planmarks/KUTSU-Pollution-Detector/KUTSU 1.0/Case/V1-Slim/V1-2/Kutsu-Case-Slim.png

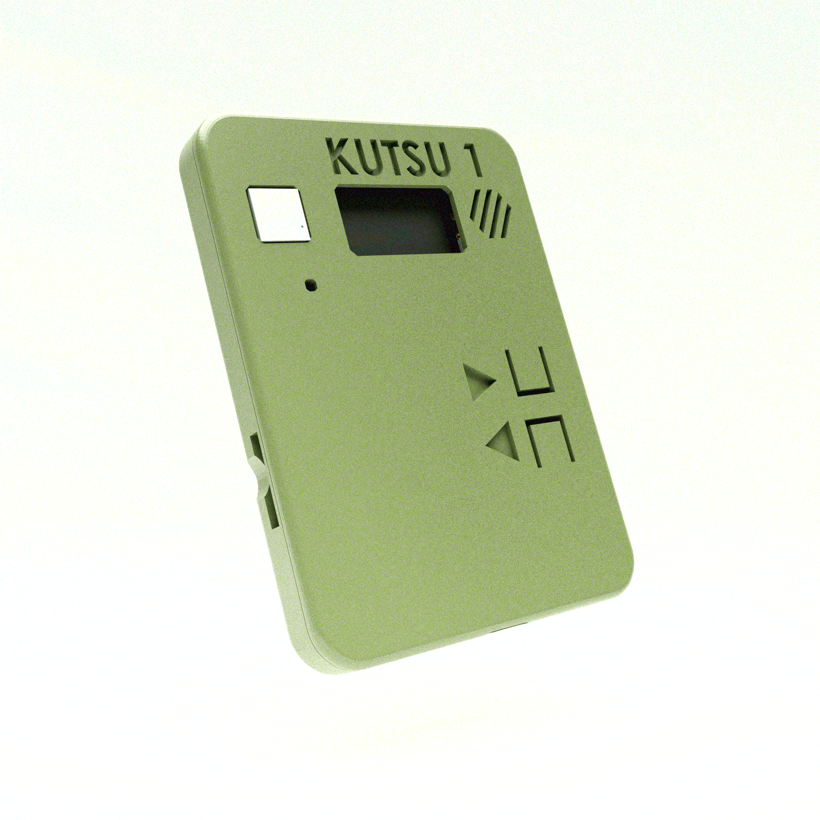
KUTSU 1.0/Case/V1-Slim/V1-2/Kutsu-Case-Slim.png
