planmarks/KUTSU-Pollution-Detector/KUTSU DIY/KUTSU Stationary/Firmware/KutsuSense/BOM.txt

Model	Use	Qty	Buy Link	Datasheet
ESP32-C5-DevKitC-1	MC	1		https://docs.espressif.com/projects/esp-dev-kits/en/latest/esp32c5/esp32-c5-devkitc-1/user_guide_v1.1.html
0.96" I2C OLED Display	Display	1	https://www.mouser.ee/ProductDetail/392-CSANAVIDISPLAY1	https://controllerstech.com/arduino-ssd1306-oled-display-tutorial/
HTU21D-F Temp & Humidity Sensor B/O	Term & Hum	1	https://www.mouser.ee/ProductDetail/485-1899	https://learn.adafruit.com/adafruit-htu21d-f-temperature-humidity-sensor/pinouts
CCS811 Carbon Dioxide Gas Sensor	CO2	1		
MQ-2 Gas and Smoke Sensor Module	Gasses	1		
"Adafruit Micro SD SPI or SDIO Card Breakout Board - 3V - 
4682 "	Memory	1	https://www.mouser.ee/ProductDetail/485-4682	https://learn.adafruit.com/adafruit-microsd-spi-sdio/pinouts
Buzzer 12 mm x 6.8 mm deep, P, 3 V, 78 dB, Through Hole, Audio Transducer -	Buzzer	1	https://www.mouser.ee/ProductDetail/179-CPT-1206-3TH-T	https://www.mouser.ee/datasheet/3/6118/1/cpt_1206_3th_t.pdf
LED Diode	Indicator	3
