planmarks/KUTSU-Pollution-Detector/KUTSU 1.0/BOM/Muru Product Compliance - Kutsu.csv

Reference | Qty | Part nr. / Value | MPN | Footprint | Buy Link 1 | Buy Link 2 | Datasheet | RoHS Comp | RoHS Docs | EMC Test link | CPU | Cost
XIAO | 1 | XIAO ESP32-C5 | 100010048 |  | https://www.digikey.ee/en/products/detail/seeed-technology-co-ltd/100010048/28959910 |  | https://files.seeedstudio.com/Bazaar/product_pdf/100010048.pdf | ROHS3 Compliant | https://files.seeedstudio.com/Seeed_Certificate/documents_certificate/100010048-ROHS.pdf |  | $6.90 | $6.90
XIAO | 1 | XIAO ESP32-C3 | 113991054 |  | https://www.digikey.ee/en/products/detail/seeed-technology-co-ltd/113991054/16652880 |  | https://mm.digikey.com/Volume0/opasdata/d220001/medias/docus/6209/Seeed%20113991054.pdf | ROHS3 Compliant | https://files.seeedstudio.com/Seeed_Certificate/documents_certificate/113991054-ROHS.pdf |  | $5.25 | $5.25
DS1 (DIY) | 1 | 0.96" I2C OLED Display | DLC0096DNOG-W-10 |  | https://www.digikey.ee/en/products/detail/dlc-display-co-ltd/DLC0096DNOG-W-10/24764440 |  | https://www.dlcdisplay.com/viewfilebizce/1793559811954421760/DLC0096DNOG-W-10.pdf | ROHS3 Compliant | No public RoHS doc found - request from DLC Display |  | $3.30 | $3.30
DS1 | 1 | OLED-128O064D 128×64 | DLC0096DNOG-W-5 |  | https://www.digikey.ee/en/products/detail/dlc-display-co-ltd/dlc0096dnog-w-5/13624832 |  | https://www.dlcdisplay.com/viewfilebizce/1760131013944299520/DLC0096DNOG-W-5.pdf | RoHS Compliant |  |  | €18.48 | €18.48
U3 | 1 | SCD41-D-R2 | SCD41-D-R2 |  | https://www.digikey.ee/en/products/detail/sensirion-ag/scd41-d-r2/13684005 |  | https://sensirion.com/media/documents/48C4B7FB/67FE0194/CD_DS_SCD4x_Datasheet_D1.pdf | ROHS3 Compliant | https://sensirion.com/media/documents/54BDF766/69E07F5E/Sensirion_REACH-RoHS-HalFree_CO2-Sensors.pdf |  | $21.77 | $21.77
U1 | 1 | SGP41-D-R4 | SGP41-D-R4 |  | https://www.digikey.ee/en/products/detail/sensirion-ag/sgp41-d-r4/15652788 |  | https://sensirion.com/media/documents/5FE8673C/61E96F50/Sensirion_Gas_Sensors_Datasheet_SGP41.pdf | ROHS3 Compliant | https://sensirion.com/media/documents/9152E5A6/69E080A2/Sensirion_REACH-RoHS-HalFree_Humidity-Temperature.pdf |  | $9.01 | $9.01
U2 | 1 | SHT40-AD1B-R3 | SHT40-AD1B-R3 |  | https://www.digikey.ee/en/products/detail/sensirion-ag/sht40-ad1b-r3/14322709 |  | https://sensirion.com/media/documents/33FD6951/6A7C10A0/HT_DS_Datasheet_SHT4x_V7.3.pdf | ROHS3 Compliant | https://sensirion.com/media/documents/9152E5A6/69E080A2/Sensirion_REACH-RoHS-HalFree_Humidity-Temperature.pdf |  | $1.88 | $1.88
D2 | 1 | Red LED Diode | LTST-C190KRKT | 603 | https://www.digikey.ee/en/products/detail/liteon/LTST-C190KRKT/386817 |  | https://optoelectronics.liteon.com/upload/download/DS-22-99-0151/LTST-C190KRKT.pdf | ROHS3 Compliant | https://optoelectronics.liteon.com/en-global/Page/RoHS |  | $0.14 | $0.14
SW1-SW3 | 3 | Push button | PTS526SK15SMTR2 LFS |  | https://www.digikey.ee/en/products/detail/c-k/PTS526SK15SMTR2-LFS/10056626 |  | https://www.littelfuse.com/assetdocs/littelfuse-c-k-tactile-pts526-series-datasheet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 | ROHS3 Compliant | https://www.littelfuse.com/assetdocs/coc-rohs10-08-18-2022?assetguid=6d7cc3c6-97e3-4940-98fc-322868282297 |  | $0.16 | $0.64
SW4 | 1 | On-Off Switch | OS102011MA1QN1 |  | https://www.digikey.ee/en/products/detail/c-k/OS102011MA1QN1/1981430 |  | https://www.littelfuse.com/assetdocs/littelfuse-c-k-slide-os-series-datasheet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 | ROHS3 Compliant | https://www.littelfuse.com/assetdocs/coc-rohs10-08-18-2022?assetguid=6d7cc3c6-97e3-4940-98fc-322868282297 |  | $0.71 | $0.71
MicroSD Connector | 1 | MSD-11-A | CONN MICROSD CARD R/A SMD |  | https://www.digikey.ee/en/products/detail/same-sky-formerly-cui-devices/msd-11-a/21798680 |  | https://www.cuidevices.com/product/resource/digikeypdf/msd-11-a.pdf | RoHS Compliant | https://www.sameskydevices.com/product/resource/material-compliance/msd-11-a |  | $0.42 | $0.42
C1 | 1 | 10uF | C0805C106K8PACTU | 805 | https://www.digikey.ee/en/products/detail/kemet/C0805C106K8PACTU/1090830 |  | https://yageogroup.com/content/datasheet/asset/file/KEM_C1006_X5R_SMD | ROHS3 Compliant | https://yageogroup.com/component-documentation/download/rohs/C0805C106K8PACTU.pdf |  | $0.17 | $0.17
C2, C3, C4, C5, C6, C7 | 6 | 0.1uF | C0805C104K5RACTU | 805 | https://www.digikey.ee/en/products/detail/kemet/C0805C104K5RACTU/411169 |  | https://yageogroup.com/content/datasheet/asset/file/KEM_C1002_X7R_SMD | ROHS3 Compliant | https://yageogroup.com/component-documentation/download/rohs/C0805C104K5RACTU.pdf |  | $0.16 | $0.96
R1, R2, R3, R4, R5, R6, R7, R10, R11 | 9 | 4.7K | RC0805FR-074K7L | 805 | https://www.digikey.ee/en/products/detail/yageo/RC0805FR-074K7L/727929 |  | https://yageogroup.com/content/datasheet/asset/file/PYU-RC_GROUP_51_ROHS_L | ROHS3 Compliant | https://yageogroup.com/content/Resource%20Library/Product%20Environmental%20Compliance/RoHS_Compliance_YAGEO.pdf |  | $0.10 | $0.90
R8 | 1 | 20K | RC0402FR-0720KL | 805 | https://www.digikey.ee/en/products/detail/yageo/RC0402FR-0720KL/726557 |  | https://yageogroup.com/content/datasheet/asset/file/PYU-RC_GROUP_51_ROHS_LL | ROHS3 Compliant | https://yageogroup.com/content/Resource%20Library/Product%20Environmental%20Compliance/RoHS_Compliance_YAGEO.pdf |  | $0.10 | $0.10
R9 | 1 | 10K | RMCF0805FT10K0 | 805 | https://www.digikey.ee/en/products/detail/stackpole-electronics-inc/RMCF0805FT10K0/1760676 |  | https://www.seielect.com/catalog/SEI-RMCF_RMCP.pdf | ROHS3 Compliant | https://www.seielect.com/catalog/SEI-RoHS_Compliance_Status.pdf |  | $0.10 | $0.10
MQ2 | 0-1 | MQ-2 Gas and Smoke Sensor Module |  |  |  | https://www.az-delivery.de/en/products/gas-sensor-modul |  | RoHS Compliant | https://cdn.shopify.com/s/files/1/1509/1638/files/AZ-scan20190814.pdf?104457 |  | €5.99 | €5.99
SD (DIY) | 0-1 | Adafruit Micro SD SPI |  |  |  | https://www.adafruit.com/product/4682 |  | ROHS3 Compliant | No public RoHS doc found - request from Adafruit (support@adafruit.com) |  | $3.50 | $3.50
D1 | 1 | Laser Diode | 1054 |  | https://www.digikey.ee/en/products/detail/adafruit-industries-llc/1054/5629439 |  | https://mm.digikey.com/Volume0/opasdata/d220001/medias/docus/1130/1054_Web.pdf | ROHS3 Compliant | No public RoHS doc found - request from Adafruit (support@adafruit.com) |  | $5.95 | $5.95
BZ 1 | 1 | Buzzer | SMT-1028-T-2-R |  | https://www.digikey.com.au/en/products/detail/pui-audio-inc/SMT-1028-T-2-R/6007733 |  | https://puiaudio.com/file/specs-SMT-1028-T-2-R.pdf | ROHS3 Compliant | https://puiaudio.com/rohs-reach-declaration/?pn=SMT-1028-T-2-R&print=pdf |  | $6.45 | $6.45
BZ 2 | 0-1 | Buzzer | SMT-1028-T-2-R |  | https://www.digikey.ee/en/products/detail/soberton-inc/WST-1203UX/1245301 |  | https://www.soberton.com/wp-content/uploads/2019/02/WST-1203UX.-17-Feb-2019-pdf.pdff | ROHS3 Compliant | https://www.soberton.com/wp-content/uploads/2019/10/RoHS-3.0-CoC-2019.pdf |  | $1.97 | $1.97
PCB | 1 | PCB |  |  |  |  |  | TBD - depends on PCB fab (specify lead-free HASL/ENIG) | TBD - request RoHS report from PCB fab |  | $5.00 | $0.50
 |  |  |  |  |  |  |  |  |  |  | Total Base | $14.84
 |  |  |  |  |  |  |  |  |  |  | Total DIY | $23.94
 |  |  |  |  |  |  |  |  |  |  | Total Base | $23.94
 |  |  |  |  |  |  |  |  |  |  | Total Pro | $70.71
