planmarks/KUTSU-Pollution-Detector/KUTSU 1.0/3D/kutsu-board-esp32c5-devkitc-test.stl

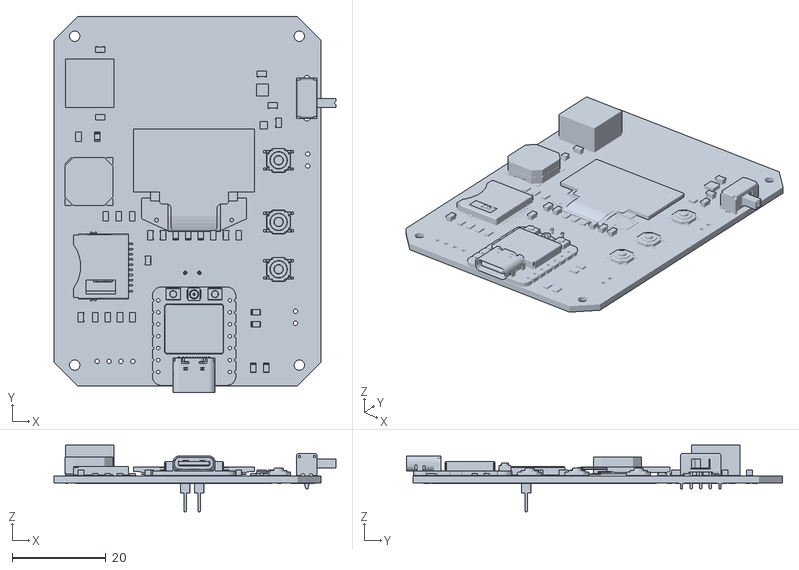
[picture p5: CAD file, 2026-10-02]
KUTSU 1.0/3D/kutsu-board-esp32c5-devkitc-test.stl
60.0 x 80.0 x 14.2
