planmarks/KUTSU-Pollution-Detector/KUTSU 1.0/Case/Kutsu 1 Case.3mf

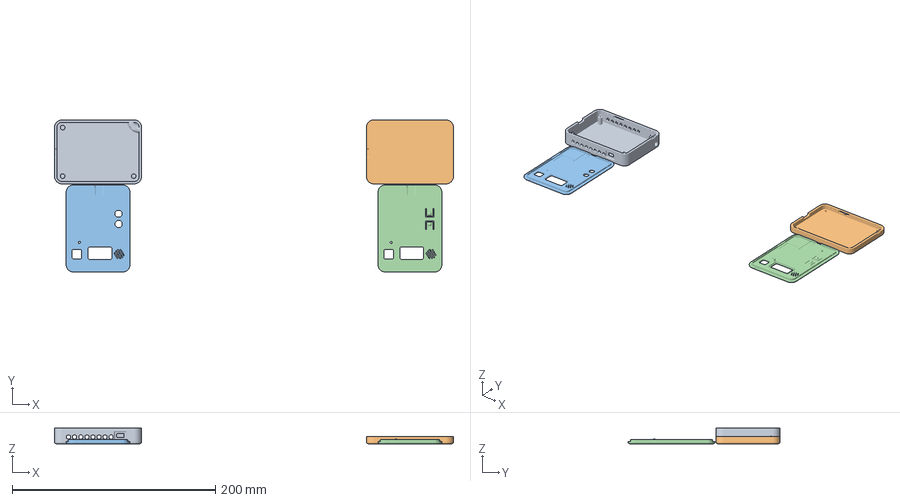
[picture p6: CAD file, 2026-10-26]
KUTSU 1.0/Case/Kutsu 1 Case.3mf
393.0 x 149.8 x 15.3 mm
Kutsu 1 CaseCaseBottom.stl
Kutsu 1 CaseCaseBottom.001.stl
Kutsu 1 CaseCsseTop.stl
Kutsu 1 CaseCsseTop.001.stl
