planmarks/KUTSU-Pollution-Detector/KUTSU 1.0/Case/V1-Slim/Kutsu 1 CaseCsseTop.001.stl

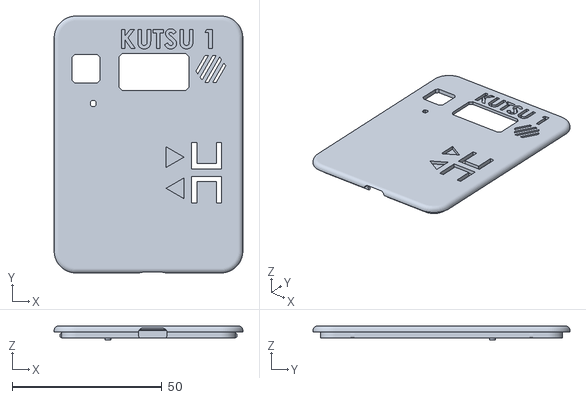
[picture p7: CAD file, 2026-10-26]
KUTSU 1.0/Case/V1-Slim/Kutsu 1 CaseCsseTop.001.stl
63.0 x 85.8 x 4.72
