planmarks/KUTSU-Pollution-Detector/KUTSU 1.0/Case/V1-Slim/V1-2/Kutsu 1 CaseCaseBottom.001.stl

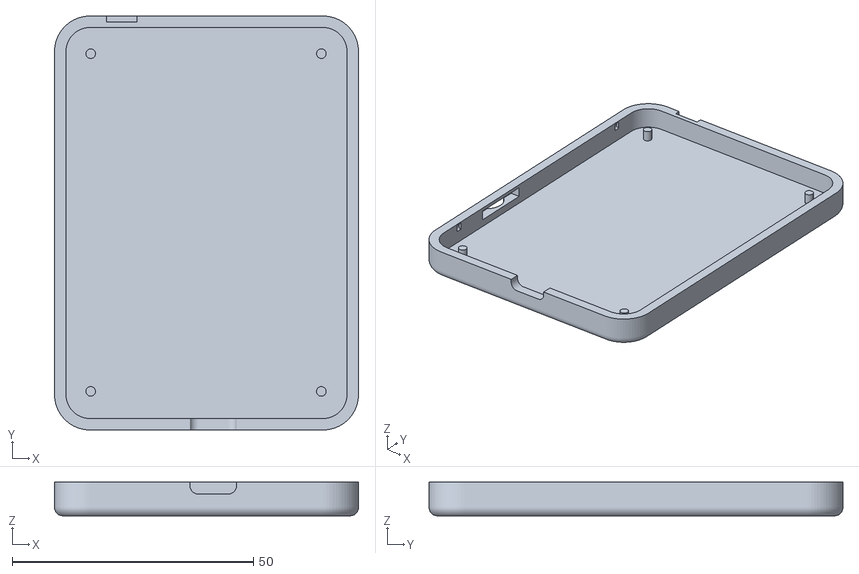
[picture p8: CAD file, 2026-10-26]
KUTSU 1.0/Case/V1-Slim/V1-2/Kutsu 1 CaseCaseBottom.001.stl
63.0 x 85.8 x 7.00
