planmarks/KUTSU-Pollution-Detector/KUTSU 1.0/Case/V1/Kutsu 1 CaseCube.002.stl

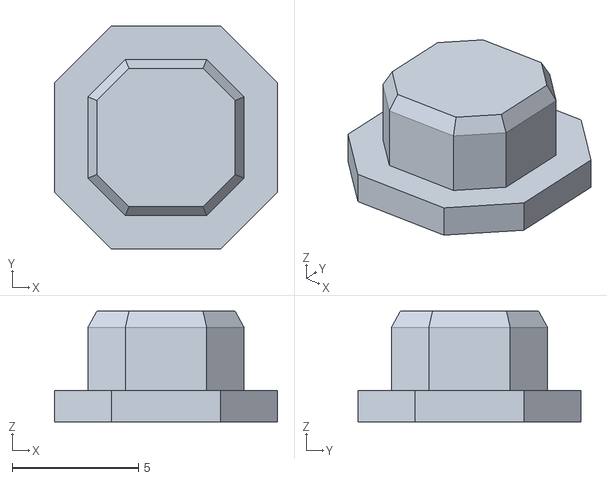
[picture p9: CAD file, 2026-10-26]
KUTSU 1.0/Case/V1/Kutsu 1 CaseCube.002.stl
8.84 x 8.84 x 4.39
