planmarks/KUTSU-Pollution-Detector/KUTSU 1.0/Case/V1/v1-1/Kutsu 1 CaseCaseBottom.stl

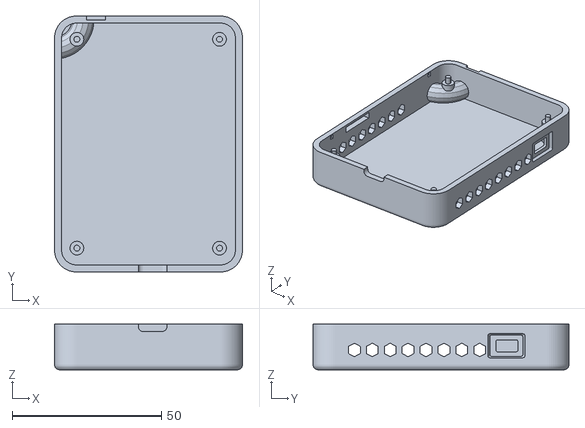
[picture p10: CAD file, 2026-10-26]
KUTSU 1.0/Case/V1/v1-1/Kutsu 1 CaseCaseBottom.stl
63.0 x 85.8 x 15.3
