planmarks/KUTSU-Pollution-Detector/KUTSU DIY/KUTSU Handheld/3D/kutsu-board-xiao-esp32c5c3.stl

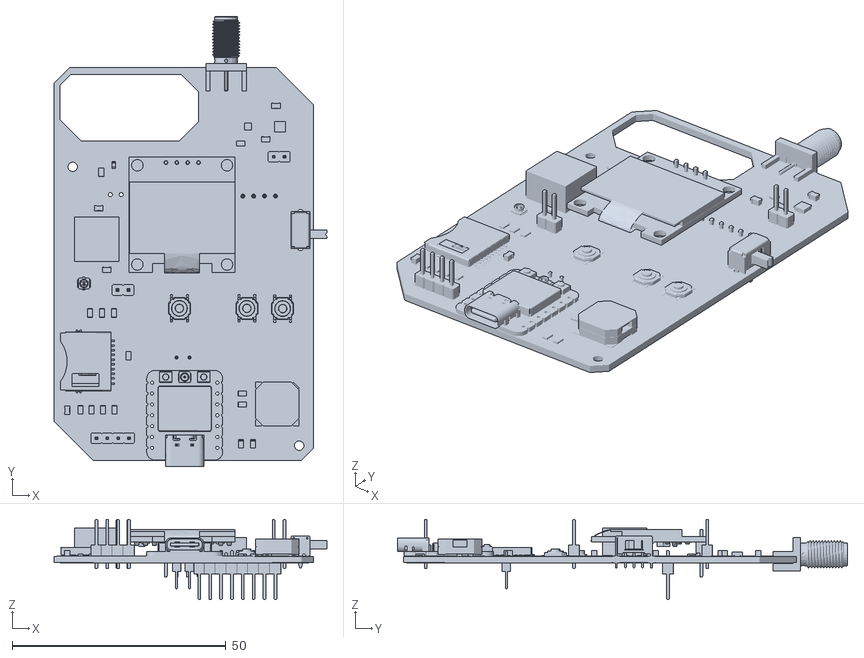
[picture p11: CAD file, 2026-10-02]
KUTSU DIY/KUTSU Handheld/3D/kutsu-board-xiao-esp32c5c3.stl
63.8 x 105.2 x 18.8
