planmarks/KUTSU-Pollution-Detector/KUTSU 1.0/Case/V1/Kutsu 1 CaseCaseBottom.001.stl

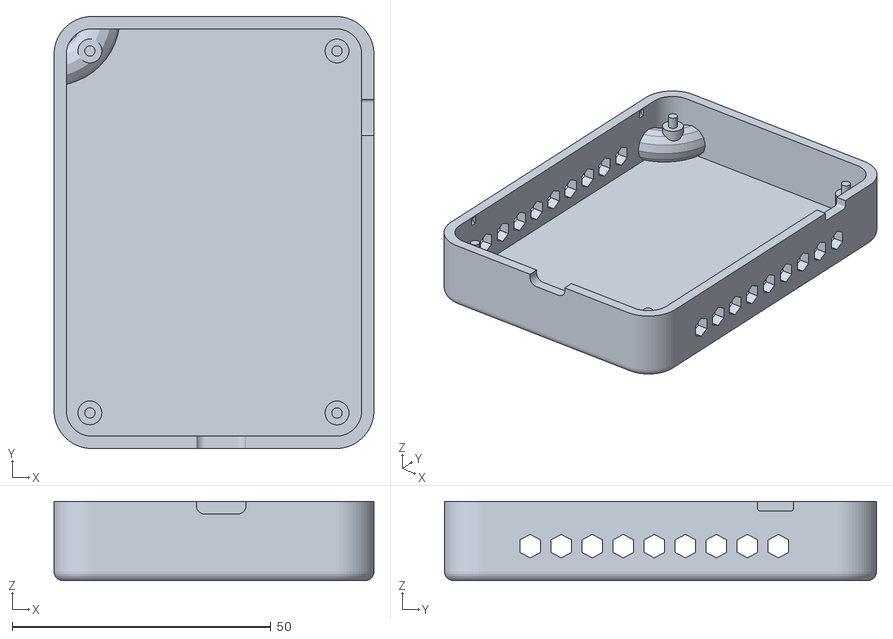
[picture p12: CAD file, 2026-10-26]
KUTSU 1.0/Case/V1/Kutsu 1 CaseCaseBottom.001.stl
61.9 x 83.6 x 15.3
