planmarks/KUTSU-Pollution-Detector/KUTSU 1.0/Case/V1/v1-1/Kutsu 1 CaseCsseTop.stl

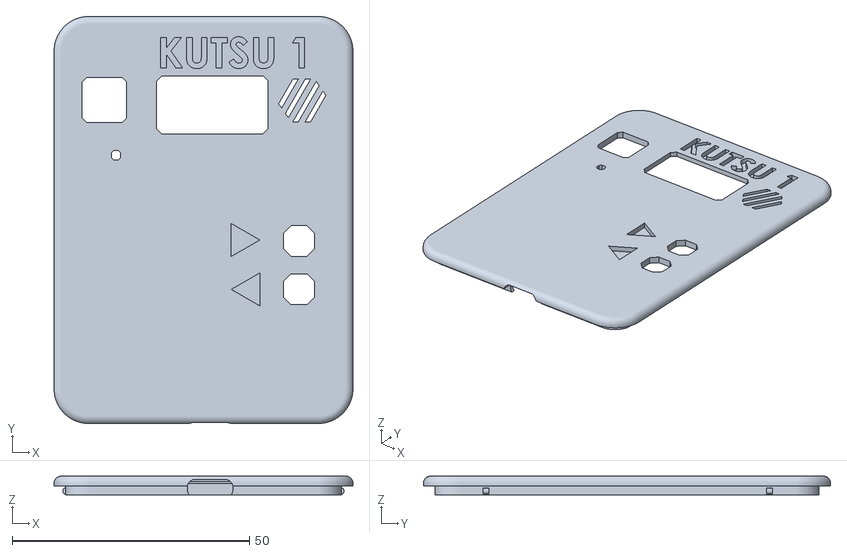
[picture p13: CAD file, 2026-10-26]
KUTSU 1.0/Case/V1/v1-1/Kutsu 1 CaseCsseTop.stl
63.0 x 85.8 x 3.98
