planmarks/KUTSU-Pollution-Detector/KUTSU 1.0/Case/V1/Kutsu 1 CaseCube.016.stl

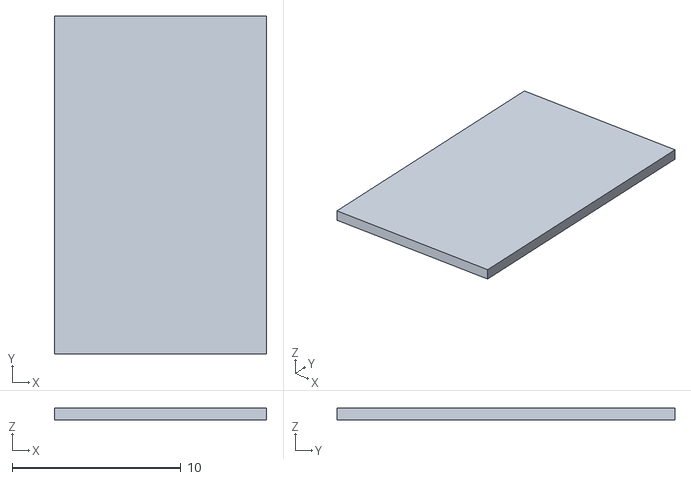
[picture p14: CAD file, 2026-10-26]
KUTSU 1.0/Case/V1/Kutsu 1 CaseCube.016.stl
12.6 x 20.0 x 0.711
