planmarks/KUTSU-Pollution-Detector/KUTSU 1.0/Case/V1/Kutsu 1 CaseCube.008.stl

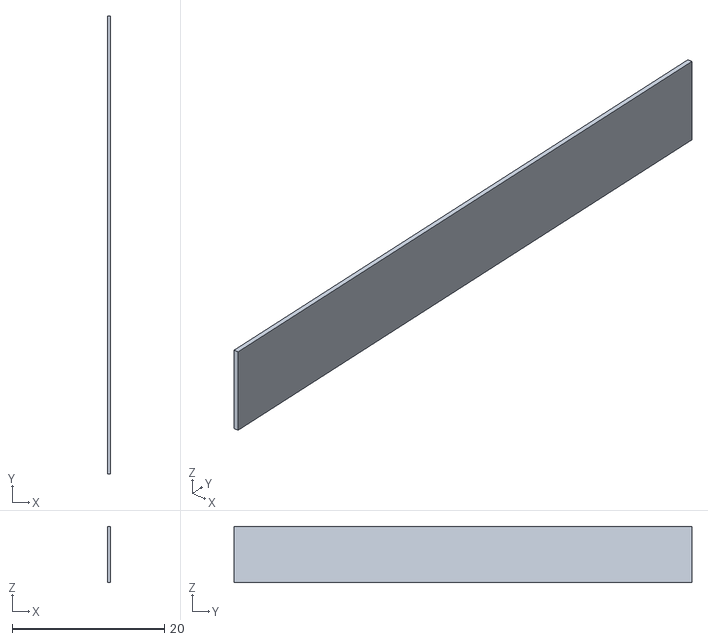
[picture p16: CAD file, 2026-10-26]
KUTSU 1.0/Case/V1/Kutsu 1 CaseCube.008.stl
0.429 x 60.2 x 7.39
