planmarks/KUTSU-Pollution-Detector/(list of files, cad)

Other CAD files:
KUTSU DIY/KUTSU Stationary/3D/kutsu-board-esp32c5-devkitc-test.stl
KUTSU 1.0/Case/V1-Slim/Kutsu 1 CaseCaseBottom.001.stl
KUTSU 1.0/Case/V1-Slim/V1-2/Kutsu 1 CaseCsseTop.001.stl
KUTSU 1.0/3D/Kutsu Handheld 3D Model.blend
KUTSU 1.0/Case/Kutsu 1 Case.blend
KUTSU 1.0/Case/Render.blend
KUTSU DIY/KUTSU Handheld/3D/Kutsu Handheld 3D Model.blend
KUTSU DIY/KUTSU Stationary/3D/Kutsu Stationary 3D Model.blend
