planmarks/KUTSU-Pollution-Detector/KUTSU 1.0/KutsuSetupApp/index.html

# Kutsu Setup

Connect a Kutsu Sense device and get it on your network.

This browser can’t talk to hardware. Open Kutsu Setup in desktop Google Chrome or Microsoft Edge (v89+). Web Bluetooth / Web Serial aren’t available in Firefox or Safari.

## Connect your device

Connect over Bluetooth Connect via USB

Power the device on and keep it nearby. Bluetooth is wireless; USB needs the cable (and works even before WiFi exists).

Need to flash or update firmware? Open Kutsu Flasher ↗ — installs the latest firmware over USB in your browser.

## Device

Connected Disconnect

## WiFi setup

Network name (SSID)

Password

Show

Room / location label (optional)

Save & connect Forget WiFi

2.4 GHz networks are the safe choice — every Kutsu module has 2.4 GHz; only the C5 also joins 5 GHz.

## Device settings

Device name

Save

A creature name is assigned at the factory. Clear the field and Save to restore it.

Mode

Stationary joins WiFi and feeds the KUTSU Hub; handheld stays off WiFi.

Handheld Stationary

Buzzer

Audible alarm on dangerous readings.

Warning LED

Lights on warning / alert.

Display

OLED screen (device keeps running when off).

WiFi & BLE scanning

Nearby networks/devices screens. Setup stays reachable either way.

Buzzer signal

Plays a preview on the device when changed.

LED — warning

How the LED behaves at warning level.

LED — alert

How the LED behaves at alert level.

Changes save to the device immediately.

## Warning thresholds

Restore defaults

Warn = the “!” level; Alert = full alarm. Blank fields are left unchanged.

## Live readings

–

CO₂ ppm

–

VOC idx

–

NOx idx

–

Temp °C

–

Hum %

Updates live while connected. Readings stream over Bluetooth, or from the device log over USB.

Activity log

Kutsu Setup · local provisioning · by Papathought · runs entirely on your computer
