planmarks/KUTSU-Pollution-Detector/KUTSU 1.0/kutsu-10-xiao-esp32c5c3.kicad_pcb

## KiCad design KUTSU 1.0/kutsu-10-xiao-esp32c5c3.kicad_pcb (2026-10-02)

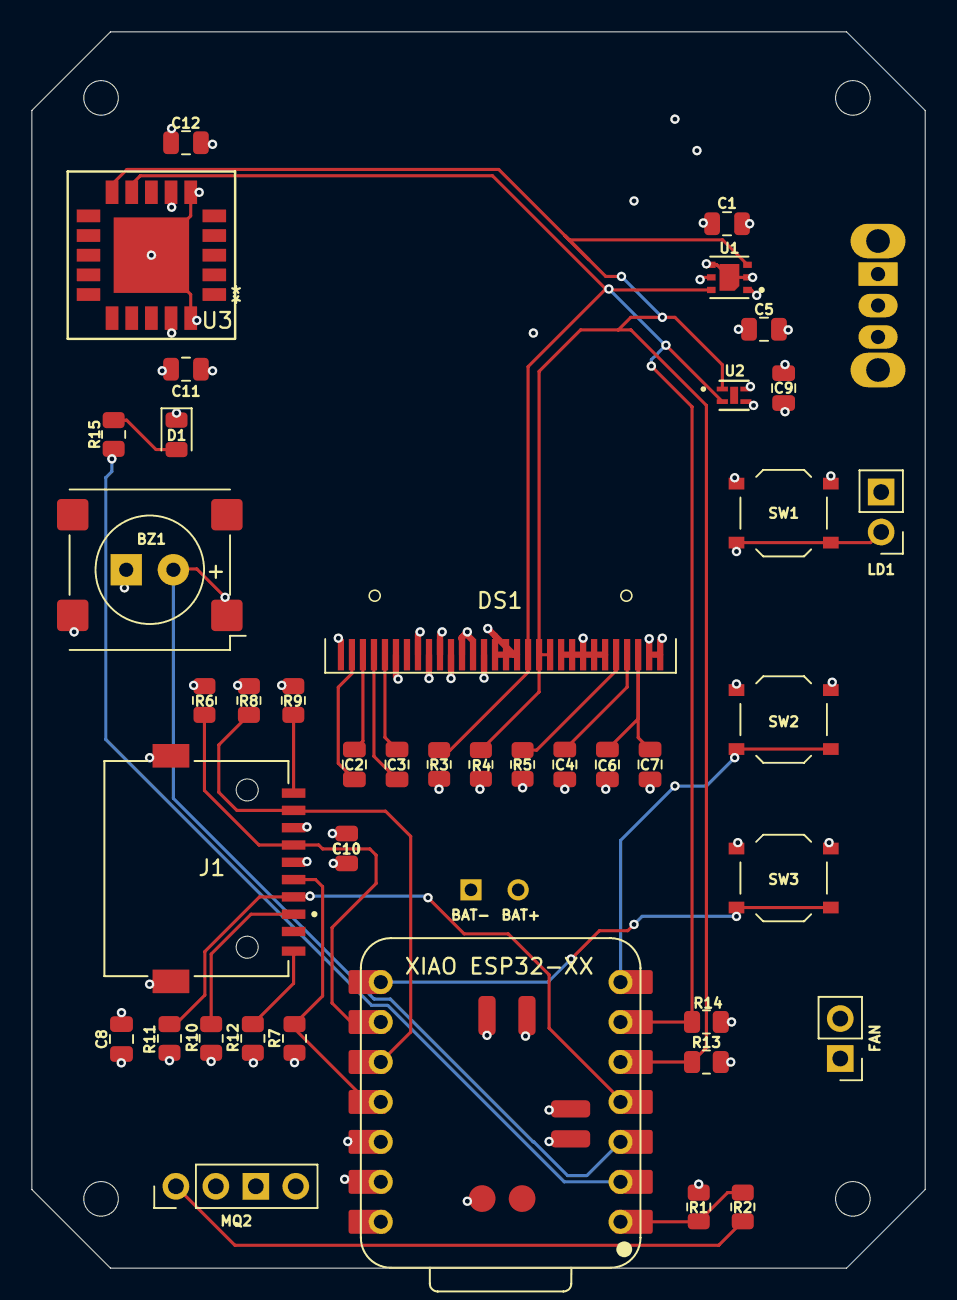
[picture p17: board kutsu-10-xiao-esp32c5c3.kicad_pcb from above]

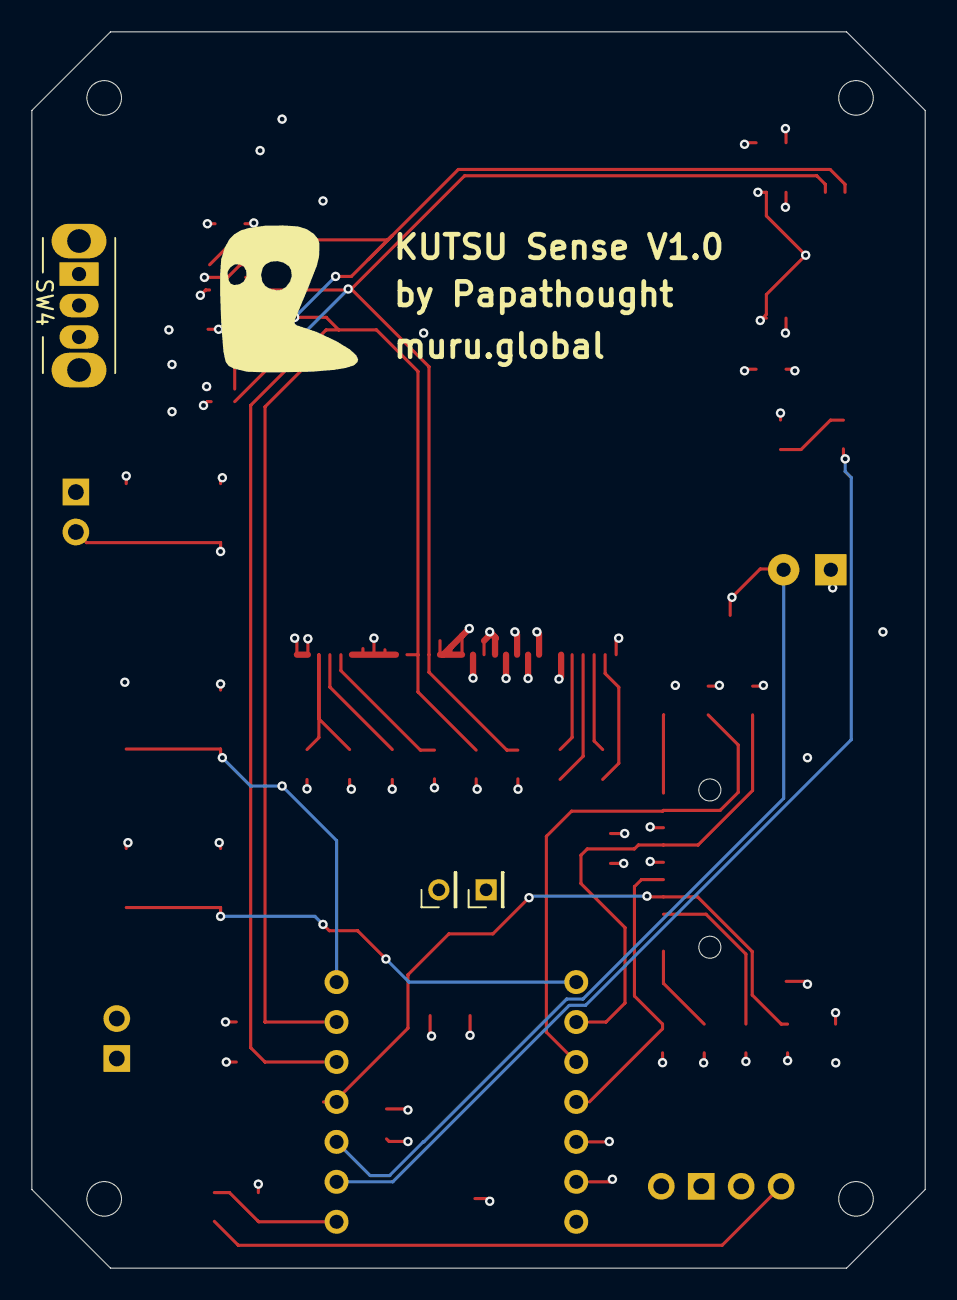
[picture p18: board kutsu-10-xiao-esp32c5c3.kicad_pcb from below]

Board: 4 copper layers, 56.8 x 78.6 mm, 45 parts (3 on the bottom side), 28 nets.

Parts:
BAT+: PinHeader_1x01_P2.00mm_Vertical
BAT-: PinHeader_1x01_P2.00mm_Vertical
BZ1: Buzzer; MagneticBuzzer_PUI_SMT-1028-T-2-R
BZ1#2: MagneticBuzzer_Kobitone_254-EMB73-RO
C1, C5, C6, C9, C10, C11, C12: 0.1uF; C_0805_2012Metric
C2, C3: 2.2 µF; C_0805_2012Metric
C4: 1uF; C_0805_2012Metric
C7: 2uF; C_0805_2012Metric
C8: 10uF; C_0805_2012Metric
D1: LED; LED_0805_2012Metric
DS1: OLED-128O064D
FAN: PinHeader_1x02_P2.54mm_Vertical
J1: MSD-11-A; CUI_MSD-11-A
LD1: D_Laser_1A3C; PinHeader_1x02_P2.54mm_Vertical
MQ2: PinHeader_1x04_P2.54mm_Vertical
R1: 20K; R_0805_2012Metric
R2: 10K; R_0805_2012Metric
R3, R4, R6, R7, R8, R9, R10, R11, R12, R13, R14, R15: 4.7K; R_0805_2012Metric
R5: 390K; R_0805_2012Metric
SW1, SW2, SW3: SW_Push; SW_Push_1P1T_XKB_TS-1187A
SW4: SW_SPDT; SW_Slide_SPDT_Angled_CK_OS102011MA1Q
U1: SGP41-D-R4; XDCR_SGP41-D-R4
U2: SHT40-AD1B-R3; DFN4_SHT4x_SEN
U3: SCD41-D-R2; QFN20_SCD41-D-R2_SEN
XIAO ESP32: XIAO-ESP32-C5-DIP

Connections:
5V: FAN.2, MQ2.4, XIAO ESP32.14
+3V3: C1.2, C5.1, C8.1, C9.1, C10.1, C11.1, C12.2, DS1.6 (VBAT), DS1.9 (VDD), DS1.11 (BS1), DS1.14 (~RES), J1.P4 (VDD), R3.1, R4.1, R6.2, R7.2, R8.2, R9.2, R10.2, R11.2, R12.2, R13.1, R14.1, SW1.2, U1.1 (VDD), U1.5 (VDDH), U2.3 (VDD), U3.7 (VDD), U3.19 (VDDH), XIAO ESP32.12
AO: MQ2.1, R2.2
BTN1: SW2.1, XIAO ESP32.7
BTN2: SW3.2, XIAO ESP32.8
BTSW1: BAT+.1, SW4.2 (B)
D1: R15.2, XIAO ESP32.2
GND: BZ1.2 (-), BZ1#2.2, C1.1, C4.2, C5.2, C6.2, C7.2, C8.2, C9.2, C10.2, C11.2, C12.1, D1.1 (K), DS1.1 (GND), DS1.8 (VSS), DS1.10 (BS0), DS1.12 (BS2), DS1.13 (~CS), DS1.15 (D/~C), DS1.16 (R/~W), DS1.17 (E/~RD), DS1.21 (D3), DS1.22 (D4), DS1.23 (D5), DS1.24 (D6), DS1.25 (D7), DS1.29 (VLSS), DS1.30 (GND), FAN.1, J1.G1 (COVER_GND), J1.G2 (COVER_GND), J1.P6 (VSS), LD1.2, MQ2.3, R1.1, R5.1, SW2.2, SW3.1, U1.2 (VSS), U1.4 (GND), U1.7 (GND), U2.4 (VSS), U3.6 (GND), U3.20 (GND), U3.21 (EPAD), XIAO ESP32.13
GPIO4: BZ1.1 (+), BZ1#2.1, XIAO ESP32.3
MQ2AO: R1.2, R2.1, XIAO ESP32.1
unnamed: D1.2 (A), R15.1
unnamed: C3.2, DS1.5 (C1N)
unnamed: C3.1, DS1.4 (C1P)
unnamed: C2.2, DS1.2 (C2N)
unnamed: C2.1, DS1.3 (C2P)
unnamed: DS1.26 (IREF), R5.2
unnamed: C6.1, C7.1, DS1.28 (VCC)
unnamed: C4.1, DS1.27 (VCOMH)
unnamed: J1.P8 (DAT1), R9.1
unnamed: J1.P1 (DAT2), R10.1
unnamed: J1.CD, R12.1
unnamed: LD1.1 (A_1), SW1.1
SCL: DS1.18 (D0), R3.2, R14.2, U1.6 (SCL), U2.2 (SCL), U3.9 (SCL), XIAO ESP32.6
SDA: DS1.19 (D1), DS1.20 (D2), R4.2, R13.2, U1.3 (SDA), U2.1 (SDA), U3.10 (SDA), XIAO ESP32.5
SDCLK: J1.P5 (CLK), R6.1, XIAO ESP32.9
SDCS: J1.P2 (CD/DAT3), R11.1, XIAO ESP32.4
SDSI: J1.P3 (CMD), R7.1, XIAO ESP32.11
SDSO: J1.P7 (DAT0), R8.1, XIAO ESP32.10
