planmarks/KUTSU-Pollution-Detector/KUTSU DIY/KUTSU Stationary/kutsu-board-esp32c5-devkitc.kicad_pcb

## KiCad design KUTSU DIY/KUTSU Stationary/kutsu-board-esp32c5-devkitc.kicad_pcb (2026-10-02)

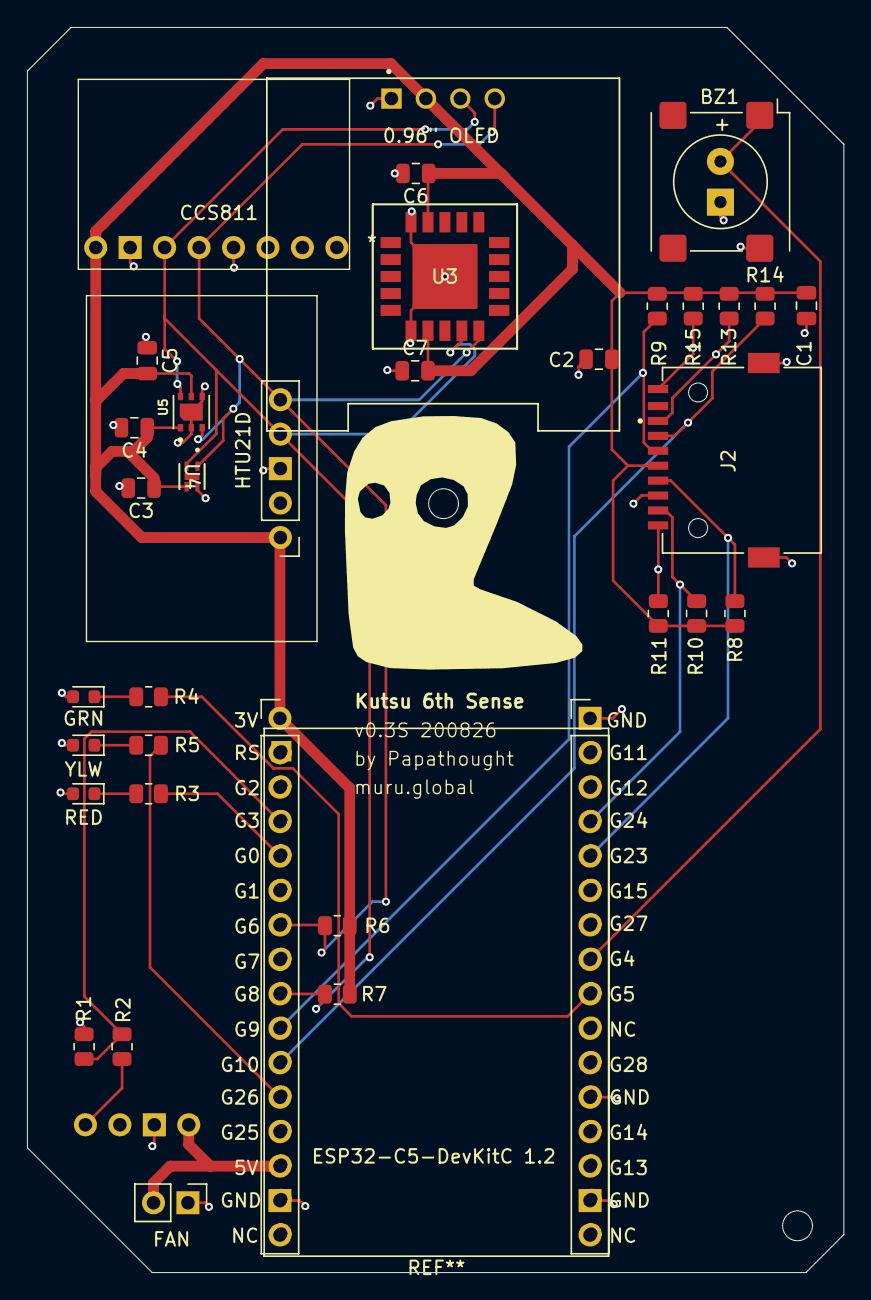
[picture p19: board kutsu-board-esp32c5-devkitc.kicad_pcb from above]

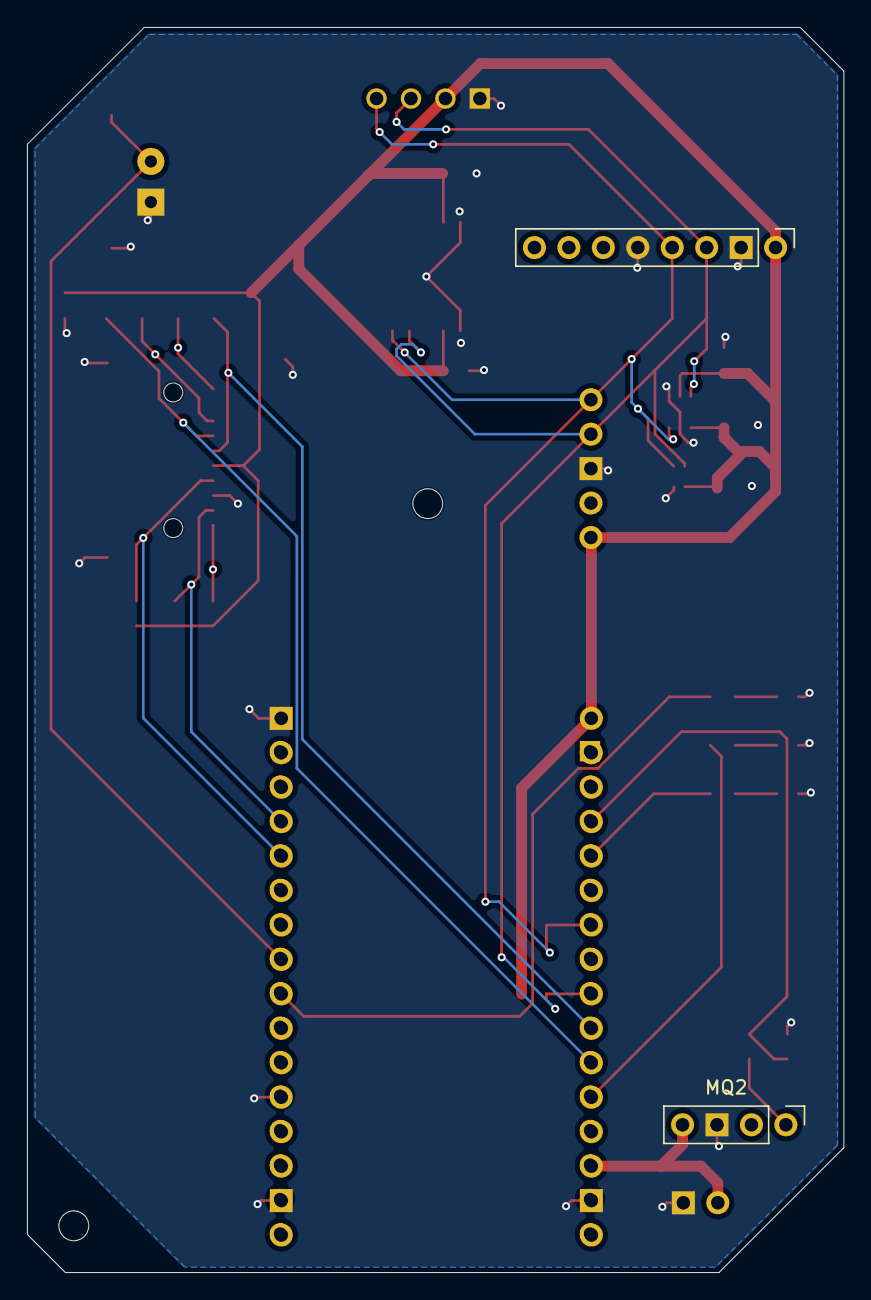
[picture p20: board kutsu-board-esp32c5-devkitc.kicad_pcb from below]

Board: 2 copper layers, 60.2 x 91.8 mm, 34 parts (2 on the bottom side), 17 nets.

Parts:
0.96" OLED: DM-OLED096-636; MODULE_DM-OLED096-636
BZ1: Buzzer; MagneticBuzzer_PUI_SMT-1028-T-2-R
C1: 10uF; C_0805_2012Metric
C2, C3, C4, C5, C6, C7: 0.1uF; C_0805_2012Metric
CCS811: PinHeader_1x08_P2.54mm_Vertical
FAN: PinHeader_1x02_P2.54mm_Vertical
GRN: LED_0603_1608Metric
HTU21D: PinHeader_1x05_P2.54mm_Vertical
J2: MSD-11-A; CUI_MSD-11-A
MQ2: PinHeader_1x04_P2.54mm_Vertical
R1: 20K; R_0805_2012Metric
R2: 10K; R_0805_2012Metric
R3, R4, R5, R6, R7, R8, R9, R10, R11, R13, R14, R15: 4.7K; R_0805_2012Metric
RED: LED_0603_1608Metric
U3: SCD41-D-R2; QFN20_SCD41-D-R2_SEN
U4: SHT40-AD1B-R3; DFN4_SHT4x_SEN
U5: SGP41-D-R4; XDCR_SGP41-D-R4
YLW: LED_0603_1608Metric

Connections:
5V: FAN.2, MQ2.4
+3V3: 0.96" OLED.2 (VCC_IN), C1.1, C2.1, C3.1, C4.1, C5.2, C6.1, C7.2, CCS811.1, HTU21D.1, J2.P4 (VDD), R6.1, R7.1, R8.2, R9.2, R10.2, R11.2, R13.2, R14.2, R15.2, U3.7 (VDD), U3.19 (VDDH), U4.3 (VDD), U5.1 (VDD), U5.5 (VDDH)
AO: MQ2.1, R2.2
GND: 0.96" OLED.1 (GND), BZ1.2 (-), C1.2, C2.2, C3.2, C4.2, C5.1, C6.2, C7.1, CCS811.2, CCS811.5, FAN.1, GRN.2, HTU21D.3, J2.G1 (COVER_GND), J2.G2 (COVER_GND), J2.P6 (VSS), MQ2.3, R1.1, RED.2, U3.6 (GND), U3.20 (GND), U3.21 (EPAD), U4.4 (VSS), U5.2 (VSS), U5.4 (GND), U5.7 (GND), YLW.2
MQ2AO: R1.2, R2.1
unnamed: R3.1, RED.1
unnamed: GRN.1, R4.1
unnamed: R5.1, YLW.1
unnamed: J2.P8 (DAT1), R11.1
unnamed: J2.P1 (DAT2), R13.1
unnamed: J2.CD, R15.1
SCL: 0.96" OLED.3 (SCL), CCS811.3, HTU21D.4, R7.2, U3.9 (SCL), U4.2 (SCL), U5.6 (SCL)
SDA: 0.96" OLED.4 (SDA), CCS811.4, HTU21D.5, R6.2, U3.10 (SDA), U4.1 (SDA), U5.3 (SDA)
SDCLK: J2.P5 (CLK), R8.1
SDCS: J2.P2 (CD/DAT3), R14.1
SDSI: J2.P3 (CMD), R9.1
SDSO: J2.P7 (DAT0), R10.1
