planmarks/KUTSU-Pollution-Detector/KUTSU DIY/KUTSU Handheld/kutsu-board-xiao-esp32c5c3.kicad_pcb

## KiCad design KUTSU DIY/KUTSU Handheld/kutsu-board-xiao-esp32c5c3.kicad_pcb (2026-10-02)

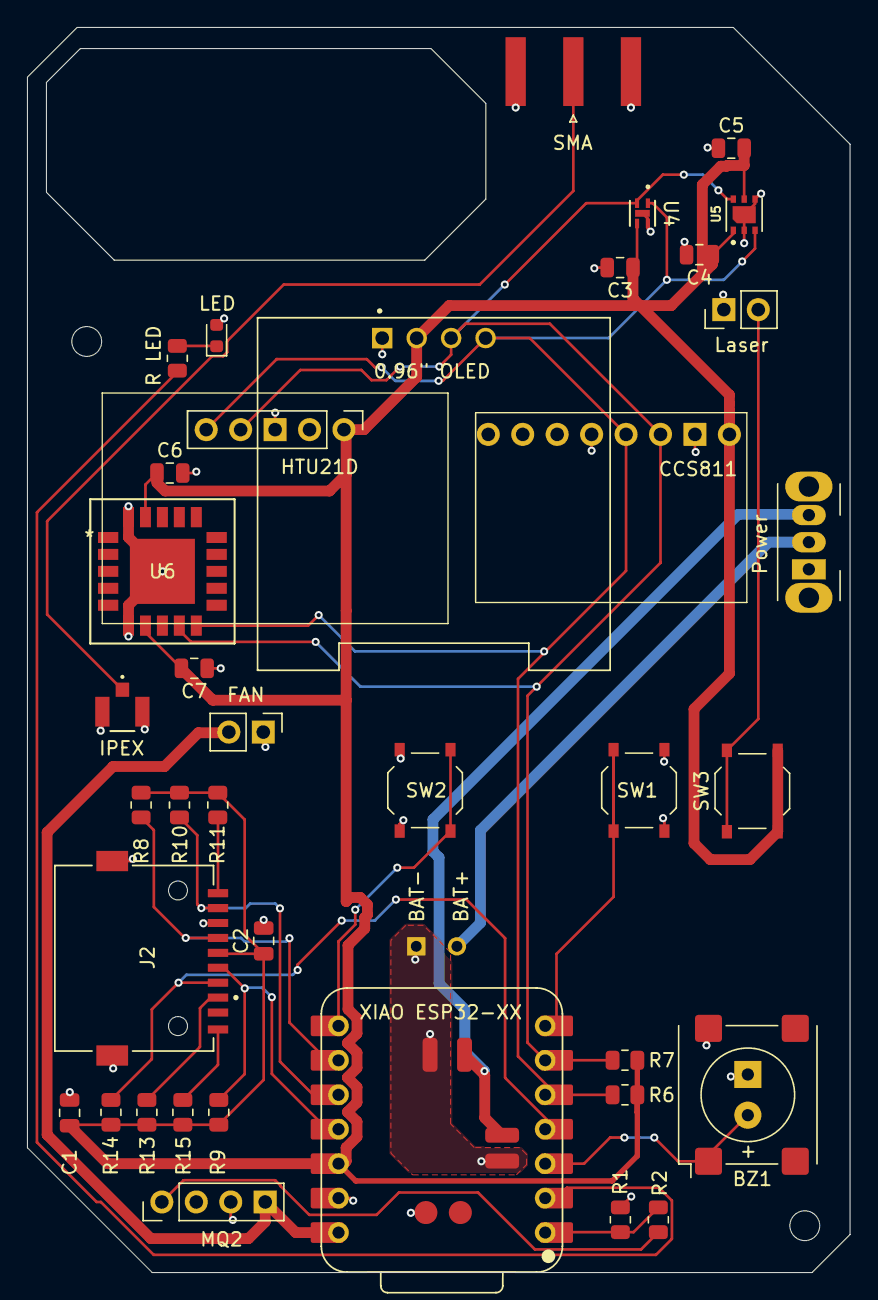
[picture p21: board kutsu-board-xiao-esp32c5c3.kicad_pcb from above]

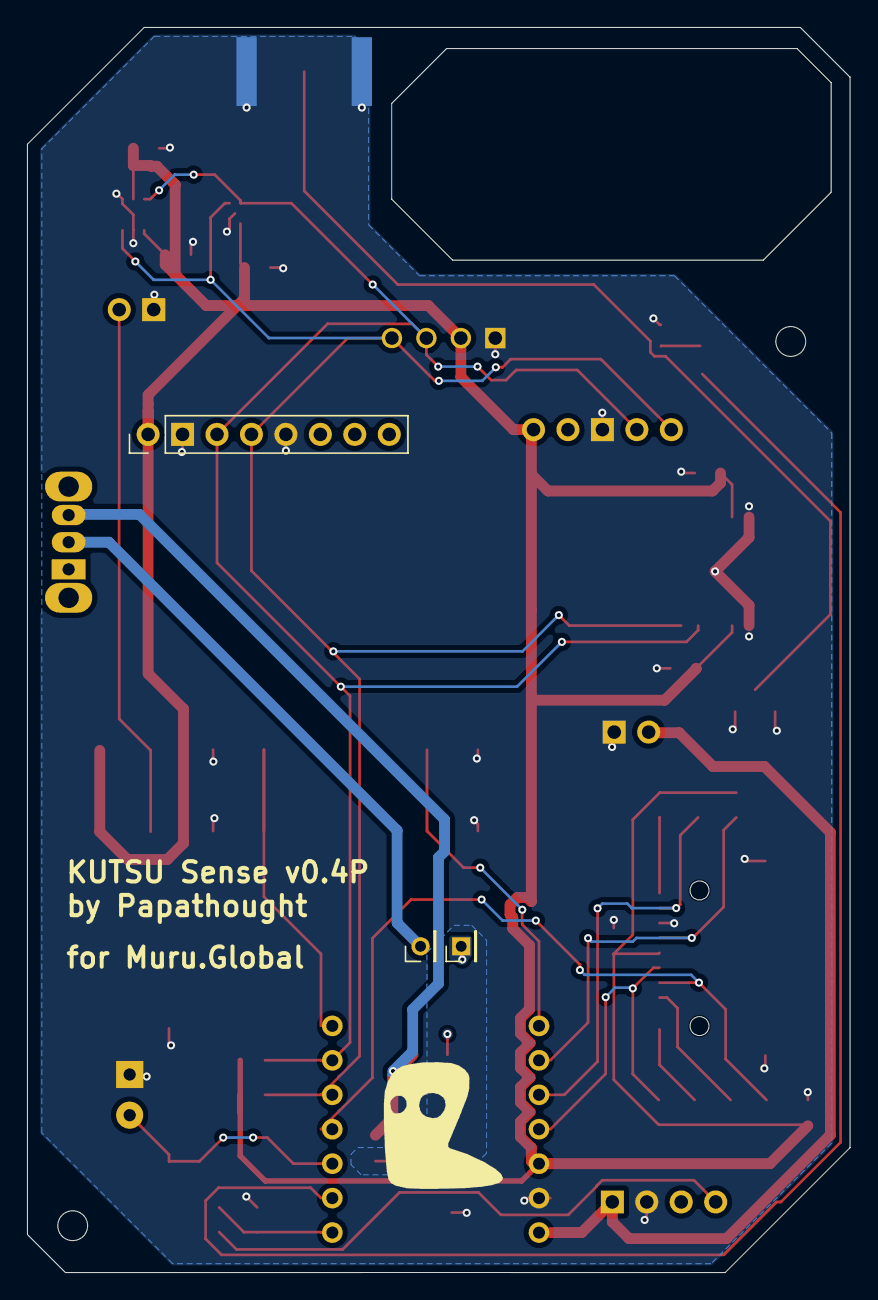
[picture p22: board kutsu-board-xiao-esp32c5c3.kicad_pcb from below]

Board: 2 copper layers, 60.7 x 91.8 mm, 41 parts (3 on the bottom side), 22 nets.

Parts:
0.96" OLED: DM-OLED096-636; MODULE_DM-OLED096-636
BAT+: PinHeader_1x01_P2.00mm_Vertical
BAT-: PinHeader_1x01_P2.00mm_Vertical
BZ1: Buzzer; MagneticBuzzer_PUI_SMT-1028-T-2-R
BZ1#2: MagneticBuzzer_Kobitone_254-EMB73-RO
C1: 10uF; C_0805_2012Metric
C2, C3, C4, C5, C6, C7: 0.1uF; C_0805_2012Metric
CCS811: PinHeader_1x08_P2.54mm_Vertical
FAN: PinHeader_1x02_P2.54mm_Vertical
HTU21D: PinHeader_1x05_P2.54mm_Vertical
IPEX: MHF_I_RECE_IPX; MHF I_RECE_IPX
J2: MSD-11-A; CUI_MSD-11-A
LED: LED_0603_1608Metric
Laser: PinHeader_1x02_P2.54mm_Vertical
MQ2: PinHeader_1x04_P2.54mm_Vertical
Power: SW_Slide_SPDT_Angled_CK_OS102011MA1Q
R1: 20K; R_0805_2012Metric
R2: 10K; R_0805_2012Metric
R6, R7, R8, R9, R10, R11, R13, R14, R15: 4.7K; R_0805_2012Metric
R LED: R_0805_2012Metric
SMA: SMA_Amphenol_132289_EdgeMount
SW1, SW2, SW3: SW_Push; SW_Push_1P1T_XKB_TS-1187A
U4: SHT40-AD1B-R3; DFN4_SHT4x_SEN
U5: SGP41-D-R4; XDCR_SGP41-D-R4
U6: SCD41-D-R2; QFN20_SCD41-D-R2_SEN
XIAO ESP32: XIAO-ESP32-C5-DIP

Connections:
5V: FAN.2, MQ2.4, XIAO ESP32.14
+3V3: 0.96" OLED.2 (VCC_IN), C1.1, C2.1, C3.1, C4.1, C5.2, C6.1, C7.2, CCS811.1, HTU21D.1, J2.P4 (VDD), R6.1, R7.1, R8.2, R9.2, R10.2, R11.2, R13.2, R14.2, R15.2, SW3.2, U4.3 (VDD), U5.1 (VDD), U5.5 (VDDH), U6.7 (VDD), U6.19 (VDDH), XIAO ESP32.12
AO: MQ2.1, R2.2
BTN1: SW1.1, XIAO ESP32.7
BTN2: SW2.2, XIAO ESP32.8
BTSW1: BAT+.1, Power.2
D1: R LED.2, XIAO ESP32.2
GND: 0.96" OLED.1 (GND), BZ1.2 (-), BZ1#2.2, C1.2, C2.2, C3.2, C4.2, C5.1, C6.2, C7.1, CCS811.2, CCS811.5, FAN.1, HTU21D.3, IPEX.1, IPEX.2, J2.G1 (COVER_GND), J2.G2 (COVER_GND), J2.P6 (VSS), LED.2, Laser.1, MQ2.3, R1.1, SMA.2, SW1.2, SW2.1, U4.4 (VSS), U4.5 (EPAD), U5.2 (VSS), U5.4 (GND), U5.7 (GND), U6.6 (GND), U6.20 (GND), U6.21 (EPAD), XIAO ESP32.13
GPIO4: BZ1.1 (+), BZ1#2.1, XIAO ESP32.3
LASER: Laser.2, SW3.1
LED-R: LED.1, R LED.1
MQ2AO: R1.2, R2.1, XIAO ESP32.1
unnamed: J2.P8 (DAT1), R11.1
unnamed: J2.P1 (DAT2), R13.1
unnamed: J2.CD, R15.1
SCL: 0.96" OLED.3 (SCL), CCS811.3, HTU21D.4, R7.2, U4.2 (SCL), U5.6 (SCL), U6.9 (SCL), XIAO ESP32.6
SDA: 0.96" OLED.4 (SDA), CCS811.4, HTU21D.5, R6.2, U4.1 (SDA), U5.3 (SDA), U6.10 (SDA), XIAO ESP32.5
SDCLK: J2.P5 (CLK), R8.1, XIAO ESP32.9
SDCS: J2.P2 (CD/DAT3), R14.1, XIAO ESP32.4
SDSI: J2.P3 (CMD), R9.1, XIAO ESP32.11
SDSO: J2.P7 (DAT0), R10.1, XIAO ESP32.10
antenna: IPEX.3, SMA.1
