planmarks/KUTSU-Pollution-Detector/(commit log)

2026-10-02 Initial commit: KUTSU hardware, firmware and docs
    [Kutsu 1 Case.blend, Kutsu Handheld 3D Model.blend, Kutsu Stationary 3D Model.blend, kutsu-10-xiao-esp32c5c3.kicad_pcb, kutsu-10-xiao-esp32c5c3.kicad_sch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]
2026-10-26 Small update
    [Kutsu 1 Case.3mf, Kutsu 1 Case.blend, Kutsu 1 CaseCaseBottom.001.stl, Kutsu 1 CaseCaseBottom.stl, Kutsu 1 CaseCsseTop.001.stl, Kutsu 1 CaseCsseTop.stl, Kutsu 1 CaseCube.002.stl, Kutsu 1 CaseCube.008.stl]
